johan-m-o/LEDTennis/images/USB_booster.jpg

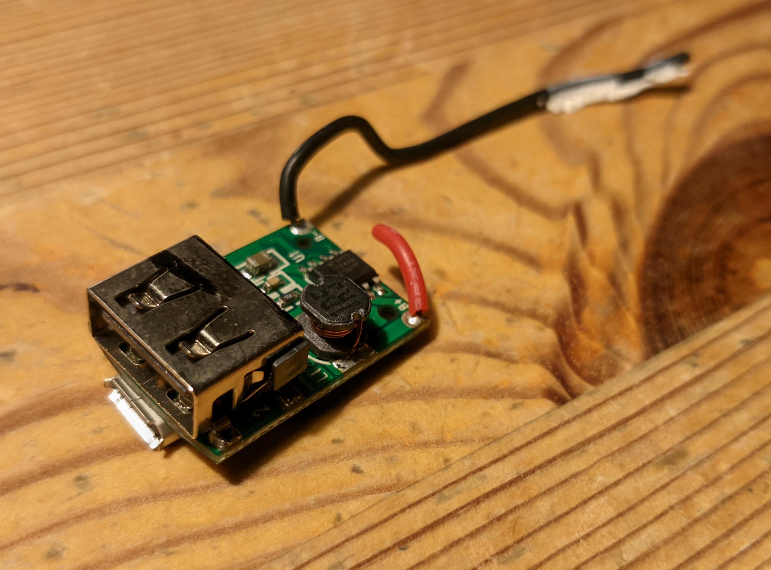
images/USB_booster.jpg
