johan-m-o/LEDTennis/(commit log)

2022-01-31 Fixed React game mode
    Completely misplace button detection reset has now found it's true home.
    [led_tennis.ino]
2022-01-31 Upload the real schematics
2022-01-31 Upload the real schematics, to the proper place
